mariusmym/WaveLight-MINI-ATtiny1626-VCNL4200-Controller/Images/photo-top-2.jpg

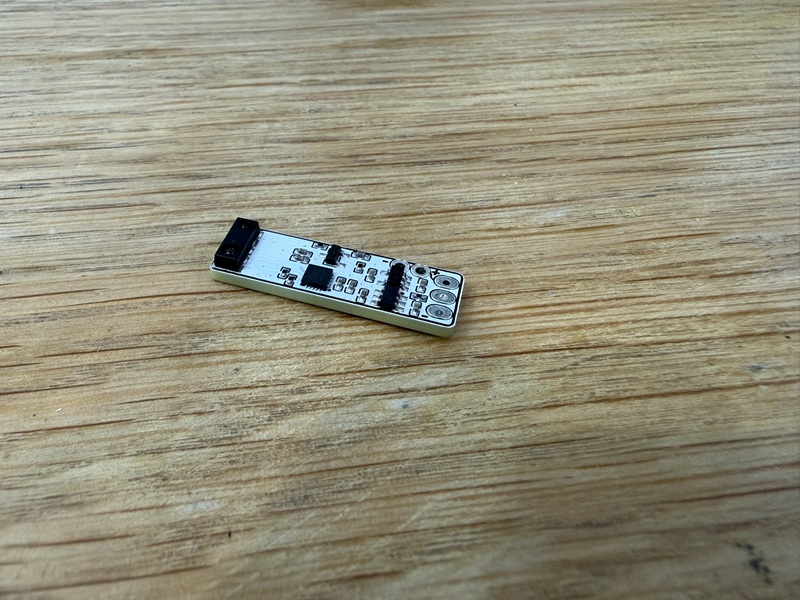
Images/photo-top-2.jpg
