mariusmym/WaveLight-MINI-ATtiny1626-VCNL4200-Controller/SCHEMATIC/Schematic_ATTiny1616-1626_VCNL4200_RGB_controller.png

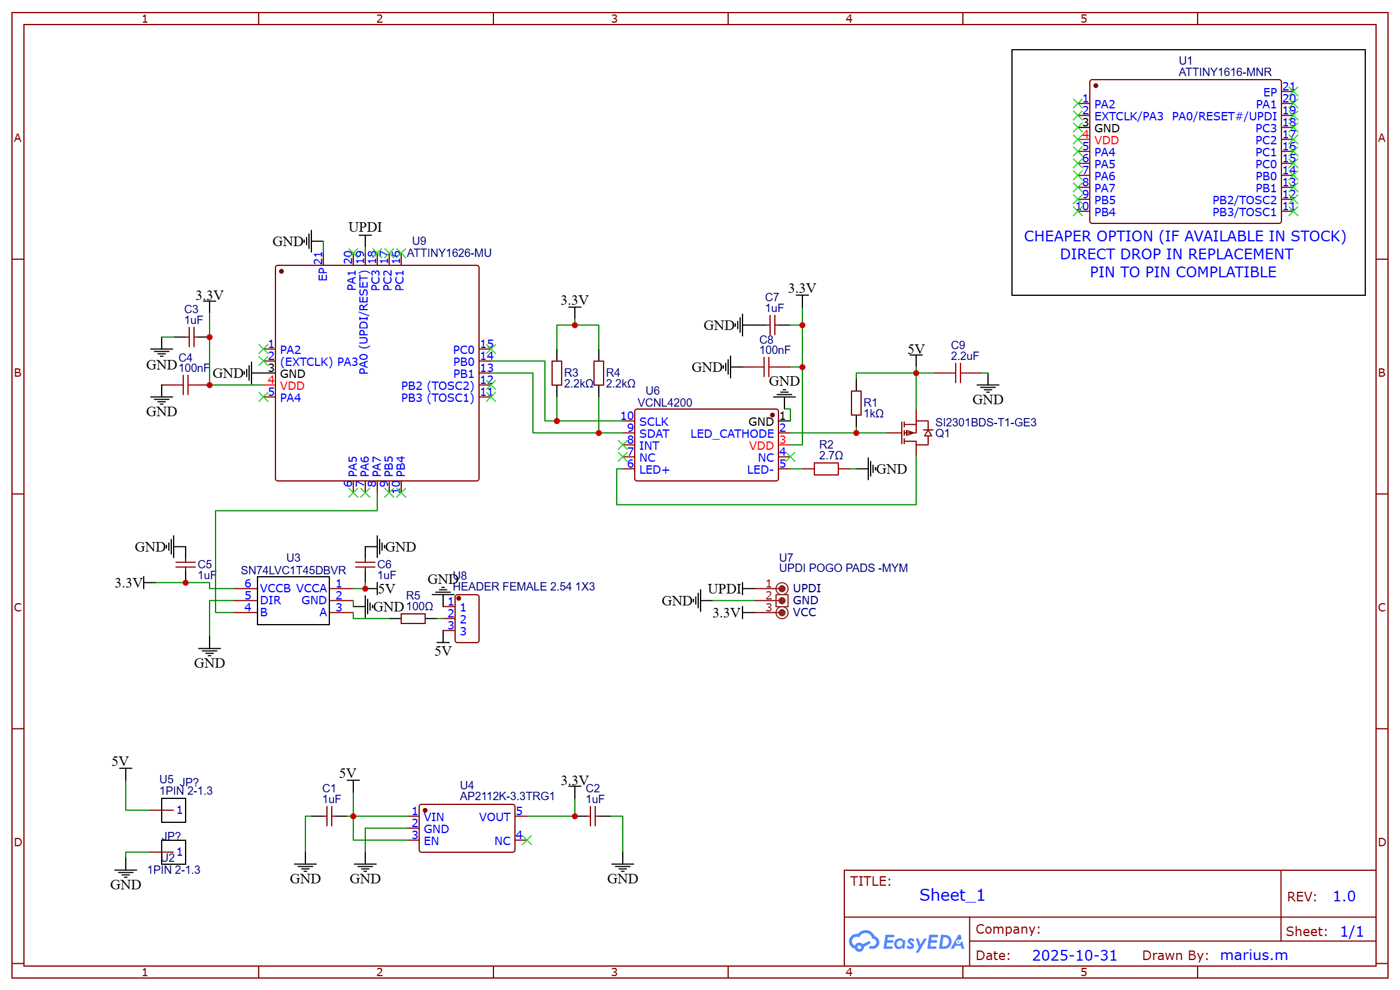
SCHEMATIC/Schematic_ATTiny1616-1626_VCNL4200_RGB_controller.png
