mariusmym/WaveLight-MINI-ATtiny1626-VCNL4200-Controller/GERBER, BOM, PNP/BOM_ATTiny1626_VCNL4200_MINI_Controller.csv

ID | Name | Designator | Footprint | Quantity | Manufacturer Part | Manufacturer | Supplier | Supplier Part
1 | ATTINY1626-MU | U9 | QFN-20_L3.0-W3.0-P0.40-TL-EP1.7 | 1 | ATTINY1626-MU | MICROCHIP(美国微芯) | LCSC | C5227676
2 | 1uF | C1,C2,C3,C5,C6,C7 | C0402 | 6 | CL05A105KO5NNNC | SAMSUNG(三星) | LCSC | C29266
3 | 100nF | C4,C8 | C0402 | 2 | CC0402KRX7R7BB104 | YAGEO(国巨) | LCSC | C60474
4 | 2.2uF | C9 | C0402 | 1 | CL05A225KO5NQNC | SAMSUNG(三星) | LCSC | C170151
5 | SI2301BDS-T1-GE3 | Q1 | SOT-23-3_L2.9-W1.6-P1.90-LS2.8-BR | 1 | SI2301BDS-T1-GE3-VB | VBsemi(微碧半导体) | LCSC | C558242
6 | 1kΩ | R1 | R0402 | 1 | RC0402FR-071KL | YAGEO(国巨) | LCSC | C106235
7 | 2.7Ω | R2 | R0402 | 1 | FRC0402F2R70TS | FOJAN(富捷) | LCSC | C2998159
8 | 2.2kΩ | R3,R4 | R0402 | 2 | RC0402FR-072K2L | YAGEO(国巨) | LCSC | C114762
9 | 100Ω | R5 | R0402 | 1 | RC0402FR-07100RL | YAGEO(国巨) | LCSC | C106232
10 | SN74LVC1T45DBVR | U3 | SOT-23-6_L2.9-W1.6-P0.95-LS2.8-BR | 1 | SN74LVC1T45DBVR | TI(德州仪器) | LCSC | C7843
11 | AP2112K-3.3TRG1 | U4 | SOT-25-5_L2.9-W1.6-P0.95-LS2.8-BL | 1 | AP2112K-3.3TRG1 | DIODES(美台) | LCSC | C51118
12 | VCNL4200 | U6 | SENSOR-SMD_VCNL4200 | 1 | VCNL4200 | VISHAY(威世) | LCSC | C510773
